louiNgn/mitten40/README.md

# mitten40 
## An ortholinear keyboard with a joystick!

The mitten40 is a 46-key, split-spacebar ortholinear keyboard with a customizable OLED screen and joystick.

### PCB Render



### PCB Layout



### Schematic


# key layout


# firmware
The mitten40 utilizes [QMK firmware](https://qmk.fm/) 

Expect coming changes to C scripts seen in the project, it's untested currently!

# case






The mitten40 utilizes a 3D printed gasket-mount case secured with M3 heat set inserts and screws.

# build guide (TO BE UPDATED ONCE I GET MY HANDS ON IT)
[View bills of materials here!](BOMs)

PCB SMD components: Options include hotplate/hot air soldering at home, assembly by a third-party service (JLCPCB is my choice), or, if you're cracked enough, hand soldering with a soldering iron.

###### FOR THE ASSEMBLY .CSV GO [HERE](production/BOM_PCBAssembly.csv)

|Designator |Footprint |Quantity|Value |LCSC Part #|
|---|---|---|---|---|
|C1, C2, C3, C5, C8 |402 |5 |100nF |C60474 |
|C10, C11, C7 |402 |3 |1uF |C29266 |
|C4, C9 |402 |2 |4.7uF |C368809 |
|C6 |402 |1 |10nF |C15195 |
|D1, D10, D11, D12, D13, D14, D15, D16, D17, D18, D19, D2, D20, D21, D22, D23, D24, D25, D26, D27, D28, D29, D3, D30, D31, D32, D33, D34, D35, D36, D37, D38, D39, D4, D40, D41, D42, D43, D44, D45, D46, D5, D6, D7, D8, D9|D_SOD-123 |46 |D |C2972760 |
|F1 |603 |1 |500mA |C136327 |
|J3 |USB_C_Receptacle_HCTL_HC-TYPE-C-16P-01A|1 |USB_C_Receptacle_USB2.0_16P|C2765186 |
|R1 |402 |1 |10k |C60490 |
|R2, R3 |402 |2 |5.1k |C25905 |
|SW0 |SW_SPST_TL3342 |1 |SW_Push |C2886898 |
|U1 |LQFP-48_7x7mm_P0.5mm |1 |STM32F072CBT6 |C81720 |
|U2 |SOT-23-6 |1 |USBLC6-2SC6 |C7519 |
|U3 |SOT-23-3 |1 |XC6206P332MR-MS |C5252899 |

Before continuing, flash QMK firmware on to the keyboard, and use a pair of conductive tweezers to test the PCB for any issues (firmware error, damaged PCB, unresponsive through-hole pins, etc...), and resolve any issues that arises (which may include reordering your PCB).

PCB through-hole components: With sufficient flux and a soldering iron, solder Cherry-MX compatible switches, joystick, and OLED screen through their respective through-hole components. Optionally, solder a 4-pin socket through the OLED screen footprint if you want easily-swappable screens/afraid of damaging the screen when soldering directly.
#### IMPORTANT: REMEMBER TO MOUNT SWITCHES ON TO THE PLATE BEFORE SANDWICHING THEM TO THE PCB AND SOLDERING THEM!!!!

|Designator |Part |Quantity|Additional notes |
|---|---|---|---|
|SW1-46 |MX-Compatible Switches |46 | |
|SW48 |PS2-style analog joystick |1 |Something similar to the [SparkFun joystick](https://www.sparkfun.com/thumb-joystick.html) should work|
|J2 |0.91" 4-pin OLED Display | |Solder sockets on if you want|

Case assembly:
+ Assuming you've mounted the switches on to the plate and the PCB before soldering, begin attaching foam gaskets you've bought on to the top of the small "fins" extruded around the plate on both sides, trimming excess material where necessary to ensure a tight fit.
+ Use your soldering iron, and optionally a heat-set insert press for more precision, push the M3 heat set inserts into their respective holes in the top housing of the keyboard case, before letting everything cool down. (NOTE: DO NOT PRESS TOO FAR AS IT MIGHT GO THROUGH THE ENTIRE HOUSING)
+ Sandwich the PCB-plate between the top and the bottom housing, ensuring the entire contraption is sitting flush in between them.
+ Use M3 screws you've bought to bolt everything together from the bottom housing, tightening it too hard may lead to the housings cracking so please avoid that.
+ Finally, attach the anti-slip nubs on to the bottom of the case in their respective nub holes, and wait for it to set into the PCB before using.

| Part | Quantity | Additional notes | Estimated total costs (may be pricier outside of my country | Links I used |
|---|---|---|---|---|
| Heat-set inserts (M3 * 4 * 4.5) | 8 | | $0.60 | [Shopee](https://shopee.vn/30-%E1%BB%90c-c%E1%BA%A5y-nhi%E1%BB%87t-%C4%91%E1%BB%93ng-M1.4-M2-M2.5-M3-M4-M5-M6-T%C3%A1n-Ren-C%E1%BA%A5y-G%E1%BA%AFn-Nh%E1%BB%B1a-Voron-c%E1%BA%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) |
| Threaded Socket Head Cap M3 Screws | 8 | A shank around 16mm should work, though it *might* go up to 18mm. Proceed with caution. | $0.80 | [Shopee](https://shopee.vn/20C%C3%A1i-Bulong-%E1%BB%91c-Tr%E1%BB%A5-L%E1%BB%A5c-Gi%C3%A1c-trong-M3-M4-M5-M6-M8-inox304-i.801113520.42860368235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) |
| 70mm * 3.5mm * 2mm Poron Foam Gaskets  | 12 | 2mms of thickness, cut down if need be. | $6.39 | [Shopee](https://shopee.vn/B%E1%BB%99-5-Mi%E1%BA%BFng-Foam-Gasket-Poron-Thay-Th%E1%BA%BF-Cho-B%C3%A0n-Ph%C3%ADm-C%C6%A1-Gasket-Mount-Yeti-Mech-i.1065372747.46601199338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) |
| 3M SJ5302 Anti-stick nubs | 4 | | $1.20 | [Shopee](https://shopee.vn/30-N%C3%BAt-%C4%90%E1%BB%87m-Ch%E1%BB%91ng-v%E1%BB%A1-%C4%90i%E1%BB%87n-Tho%E1%BA%A1i-3M-SJ5302-(N%C3%BAt-V%C3%B2m-C%E1%BA%A7u)-v%C3%A0-20-N%C3%BAt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) |
| Filament (PLA) | ~270+ grams or ~90m (PLA) | May vary with different filaments and print settings | ~$5.40 | |
