louiNgn/mitten40/image-1.png

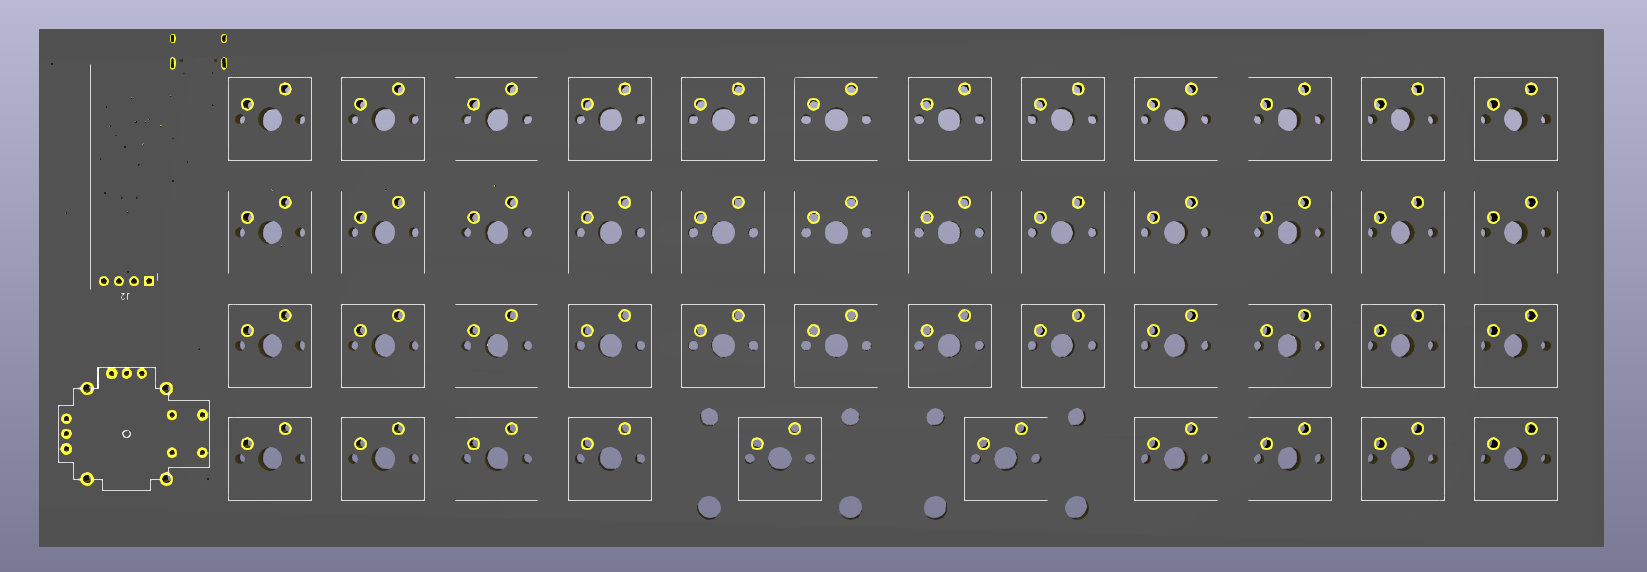
image-1.png
