louiNgn/mitten40/image-3.png

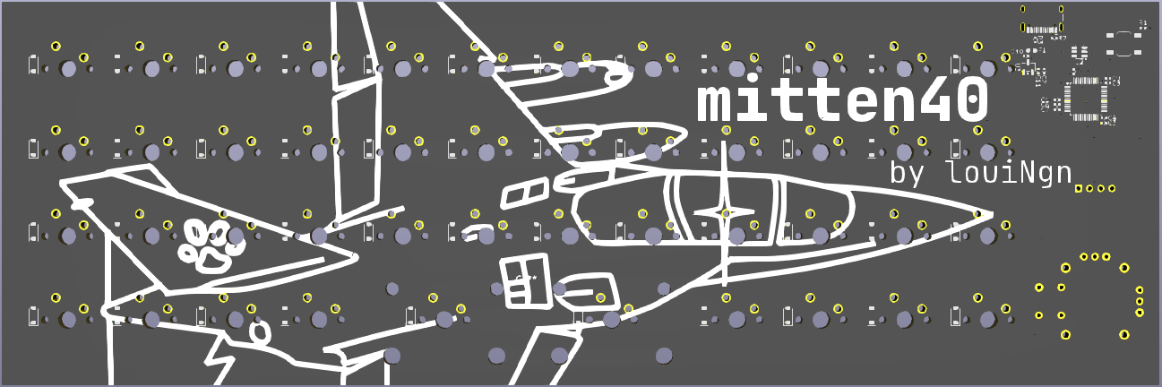
image-3.png
