louiNgn/mitten40/image.png

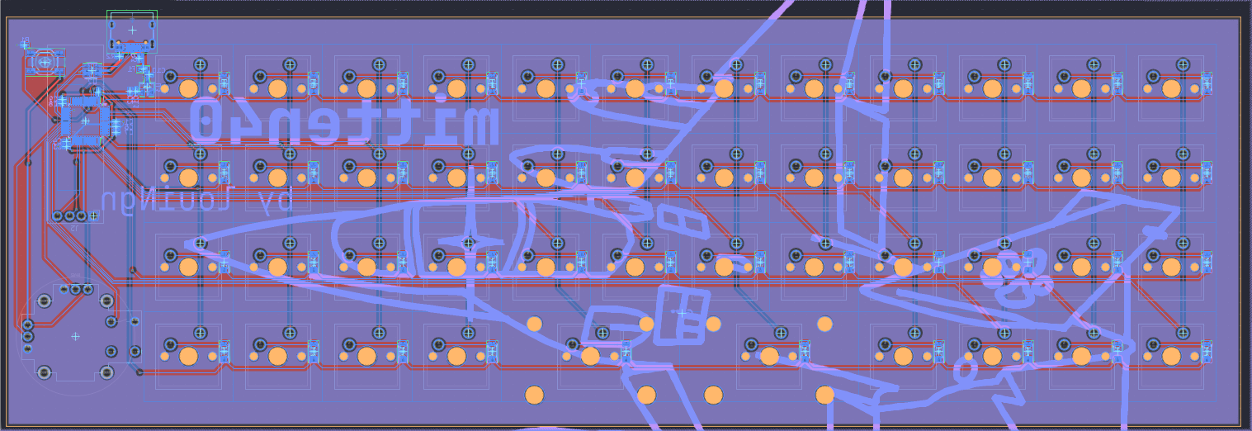
image.png
