louiNgn/mitten40/mitten40percentPCB/production/BOM_bom.csv

Designator | Footprint | Quantity | Value | LCSC Part #
C1, C2, C3, C5, C8 | 0402 | 5 | 100nF
C10, C11, C7 | 0402 | 3 | 1uF
C4, C9 | 0402 | 2 | 4.7uF
C6 | 0402 | 1 | 10nF
D1, D10, D11, D12, D13, D14, D15, D16, D17, D18, D19, D2, D20, D21, D22, D23, D24, D25, D26, D27, D28, D29, D3, D30, D31, D32, D33, D34, D35, D36, D37, D38, D39, D4, D40, D41, D42, D43, D44, D45, D46, D5, D6, D7, D8, D9 | D_SOD-123 | 46 | D
F1 | 0603 | 1 | 500mA
J2 | ER_OLEDM0.91_1x-I2C | 1 | I2C
J3 | USB_C_Receptacle_HCTL_HC-TYPE-C-16P-01A | 1 | USB_C_Receptacle_USB2.0_16P
R1 | 0402 | 1 | 10k
R2, R3 | 0402 | 2 | 5.1k
SW0 | SW_SPST_TL3342 | 1 | SW_Push
SW1, SW10, SW11, SW12, SW13, SW14, SW15, SW16, SW17, SW18, SW19, SW2, SW20, SW21, SW22, SW23, SW24, SW25, SW26, SW27, SW28, SW29, SW3, SW30, SW31, SW32, SW33, SW34, SW35, SW36, SW37, SW38, SW39, SW4, SW40, SW43, SW44, SW45, SW46, SW5, SW6, SW7, SW8, SW9 | SW_Cherry_MX_1.00u_PCB | 44 | SW_Push_45deg
SW41, SW42 | SW_Cherry_MX_2.00u_PCB | 2 | SW_Push_45deg
SW48 | Joystick_PTH | 1 | Joystick
U1 | LQFP-48_7x7mm_P0.5mm | 1 | STM32F072CBT6
U2 | SOT-23-6 | 1 | USBLC6-2SC6
U3 | SOT-23-3 | 1 | XC6206PxxxMR
