louiNgn/mitten40/mitten40percent.csv

Id | Designator | Footprint | Quantity | Designation | Supplier and ref
1 | C1, C2, C3, C5, C8 | C_0402_1005Metric | 5 | 100nF
2 | C4, C9 | C_0402_1005Metric | 2 | 4.7uF
3 | C6 | C_0402_1005Metric | 1 | 10nF
4 | C7, C10, C11 | C_0402_1005Metric | 3 | 1uF
5 | D1, D2, D3, D4, D5, D6, D7, D8, D9, D10, D11, D12, D13, D14, D15, D16, D17, D18, D19, D20, D21, D22, D23, D24, D25, D26, D27, D28, D29, D30, D31, D32, D33, D34, D35, D36, D37, D38, D39, D40, D41, D42, D43, D44, D45, D46 | D_SOD-123 | 46 | D
6 | F1 | Fuse_0603_1608Metric | 1 | 500mA
7 | J2 | ER_OLEDM0.91_1x-I2C | 1 | I2C
8 | J3 | USB_C_Receptacle_HCTL_HC-TYPE-C-16P-01A | 1 | USB_C_Receptacle_USB2.0_16P
9 | R1 | R_0402_1005Metric | 1 | 10k
10 | R2, R3 | R_0402_1005Metric | 2 | 5.1k
11 | SW0 | SW_SPST_TL3342 | 1 | SW_Push
12 | SW1, SW2, SW3, SW4, SW5, SW6, SW7, SW8, SW9, SW10, SW11, SW12, SW13, SW14, SW15, SW16, SW17, SW18, SW19, SW20, SW21, SW22, SW23, SW24, SW25, SW26, SW27, SW28, SW29, SW30, SW31, SW32, SW33, SW34, SW35, SW36, SW37, SW38, SW39, SW40, SW43, SW44, SW45, SW46 | SW_Cherry_MX_1.00u_PCB | 44 | SW_Push_45deg
13 | SW41, SW42 | SW_Cherry_MX_2.00u_PCB | 2 | SW_Push_45deg
14 | SW48 | Joystick_PTH | 1 | Joystick
15 | U1 | LQFP-48_7x7mm_P0.5mm | 1 | STM32F072CBT6
16 | U2 | SOT-23-6 | 1 | USBLC6-2SC6
17 | U3 | SOT-23-3 | 1 | XC6206PxxxMR
