louiNgn/mitten40/mitten40Case/caseBottom.3mf

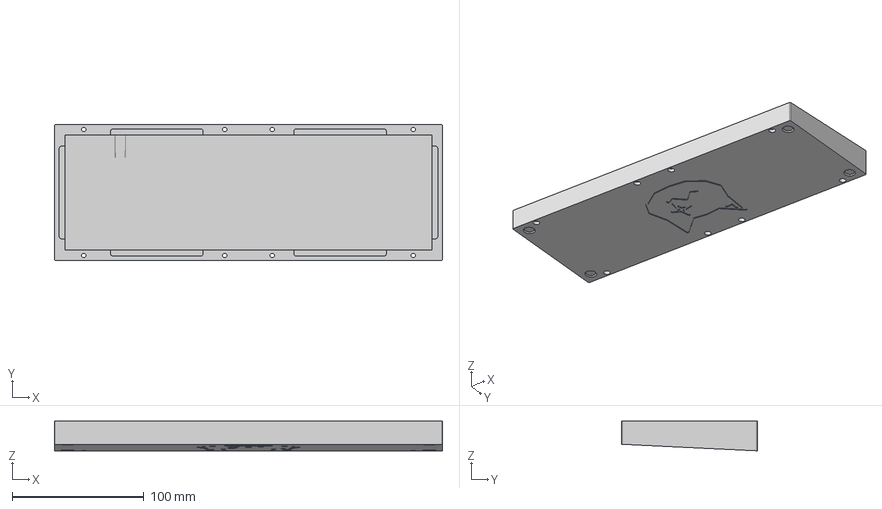
[picture p4: CAD file, 2026-10-22]
mitten40Case/caseBottom.3mf
294.5 x 103.5 x 22.6 mm
