louiNgn/mitten40/mitten40percentPCB/mitten40PCB.step

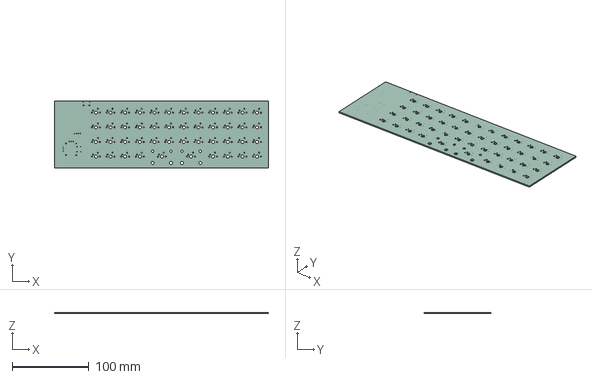
[picture p5: CAD file, 2026-10-19]
mitten40percentPCB/mitten40PCB.step
278.2 x 87.2 x 1.51 mm
