louiNgn/mitten40/mitten40Case/caseTop.3mf

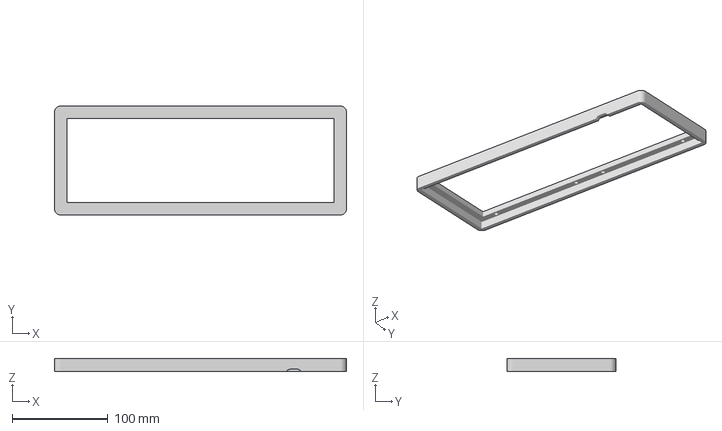
[picture p6: CAD file, 2026-10-18]
mitten40Case/caseTop.3mf
304.5 x 113.5 x 14.0 mm
