louiNgn/mitten40/mitten40Case/pcbPlate.3mf

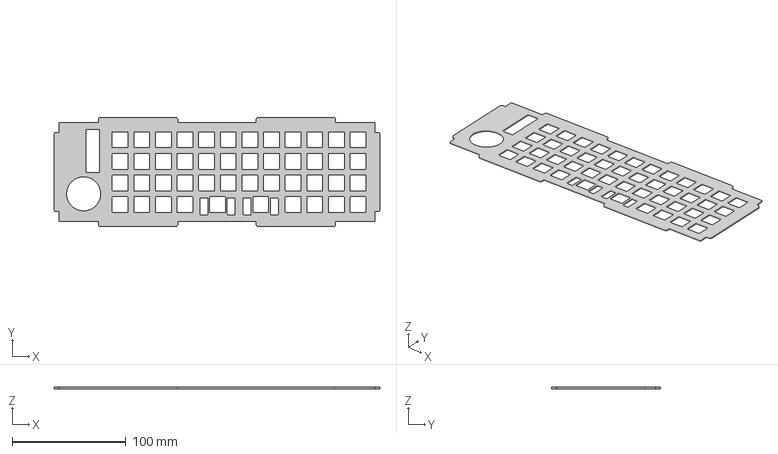
[picture p7: CAD file, 2026-10-18]
mitten40Case/pcbPlate.3mf
287.2 x 96.2 x 1.50 mm
