louiNgn/mitten40/(list of files, cad)

Other CAD files:
mitten40Case/caseBottom.f3d
mitten40Case/caseTop.f3d
mitten40Case/pcbPlate.f3d
