louiNgn/mitten40/mitten40percentPCB/mitten40percent.kicad_pcb

## KiCad design mitten40percentPCB/mitten40percent.kicad_pcb (2026-10-16)

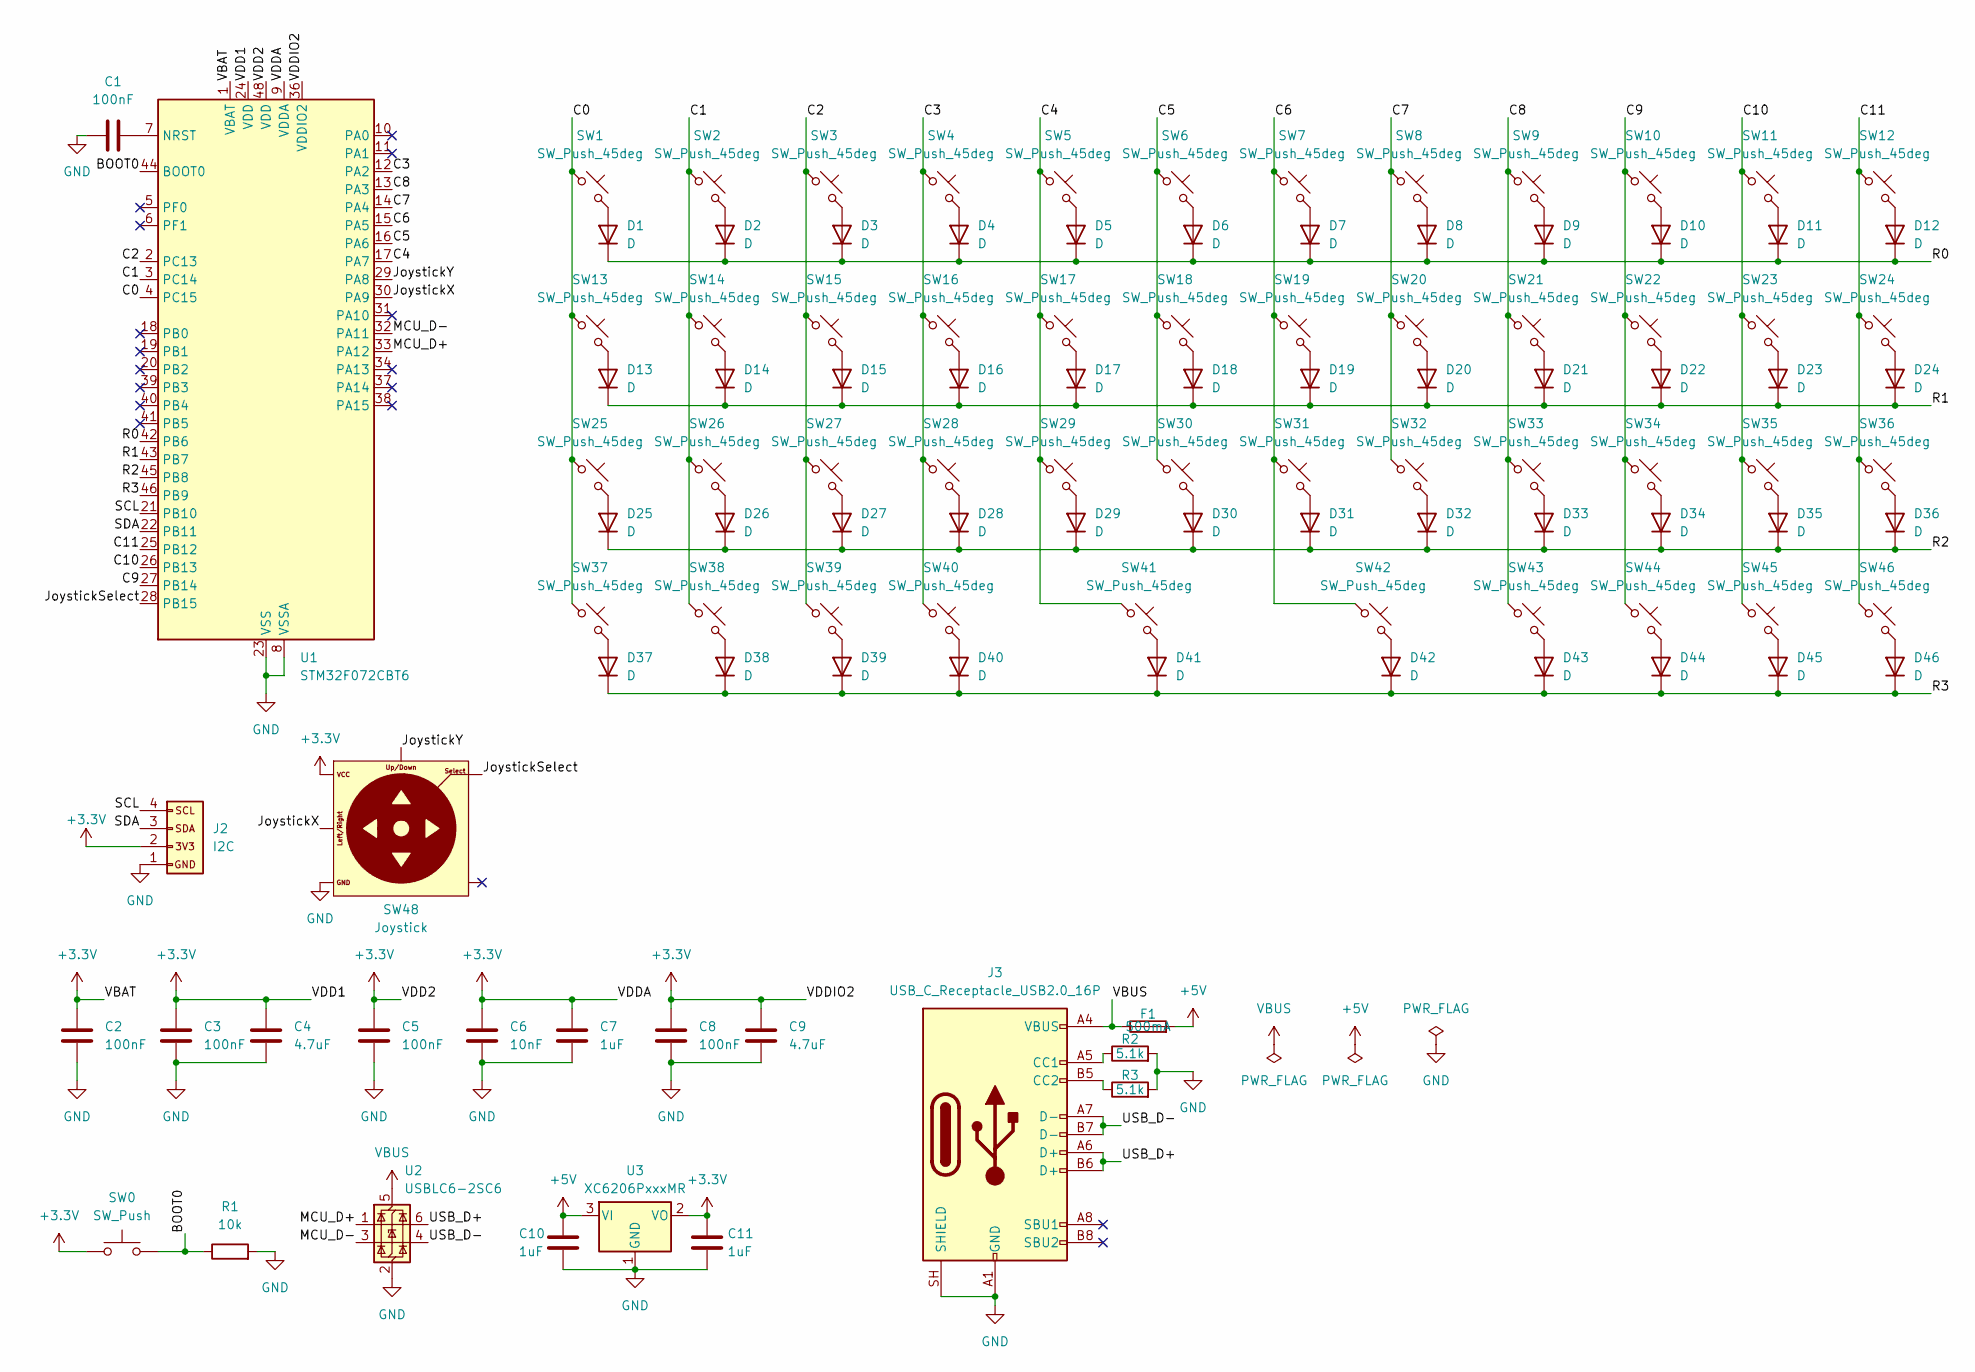
[picture p8: schematic mitten40percent.kicad_sch, mitten40 PCB]

Parts:
C1, C2, C3, C5, C8: 100nF; C_0402_1005Metric
C4, C9: 4.7uF; C_0402_1005Metric
C6: 10nF; C_0402_1005Metric
C7, C10, C11: 1uF; C_0402_1005Metric
D1, D2, D3, D4, D5, D6, D7, D8, D9, D10, D11, D12, D13, D14, D15, D16, D17, D18, D19, D20, D21, D22, D23, D24, D25, D26, D27, D28, D29, D30, D31, D32, D33, D34, D35, D36, D37, D38, D39, D40, D41, D42, D43, D44, D45, D46: D; D_SOD-123
F1: 500mA; Fuse_0603_1608Metric
J2: I2C; ER_OLEDM0.91_1x-I2C
J3: USB_C_Receptacle_USB2.0_16P; USB_C_Receptacle_HCTL_HC-TYPE-C-16P-01A
R1: 10k; R_0402_1005Metric
R2, R3: 5.1k; R_0402_1005Metric
SW0: SW_Push; SW_SPST_TL3342
SW1, SW2, SW3, SW4, SW5, SW6, SW7, SW8, SW9, SW10, SW11, SW12, SW13, SW14, SW15, SW16, SW17, SW18, SW19, SW20, SW21, SW22, SW23, SW24, SW25, SW26, SW27, SW28, SW29, SW30, SW31, SW32, SW33, SW34, SW35, SW36, SW37, SW38, SW39, SW40, SW43, SW44, SW45, SW46: SW_Push_45deg; SW_Cherry_MX_1.00u_PCB
SW41, SW42: SW_Push_45deg; SW_Cherry_MX_2.00u_PCB
SW48: Joystick; Joystick_PTH
U1: STM32F072CBT6; LQFP-48_7x7mm_P0.5mm
U2: USBLC6-2SC6; SOT-23-6
U3: XC6206PxxxMR; SOT-23-3

Connections:
+3.3V: C2.1, C3.1, C4.1, C5.1, C6.1, C7.1, C8.1, C9.1, C11.1, J2.2, SW0.1, SW48.VCC, U1.1 (VBAT), U1.9 (VDDA), U1.24 (VDD), U1.36 (VDDIO2), U1.48 (VDD), U3.2 (VO)
+5V: C10.1, F1.2, U3.3 (VI)
/BOOT0: R1.1, SW0.2, U1.44 (BOOT0)
/C0: SW1.1, SW13.1, SW25.1, SW37.1, U1.4 (PC15)
/C1: SW2.1, SW14.1, SW26.1, SW38.1, U1.3 (PC14)
/C2: SW3.1, SW15.1, SW27.1, SW39.1, U1.2 (PC13)
/C3: SW4.1, SW16.1, SW28.1, SW40.1, U1.12 (PA2)
/C4: SW5.1, SW17.1, SW29.1, SW41.1, U1.17 (PA7)
/C5: SW6.1, SW18.1, SW30.1, U1.16 (PA6)
/C6: SW7.1, SW19.1, SW31.1, SW42.1, U1.15 (PA5)
/C7: SW8.1, SW20.1, SW32.1, U1.14 (PA4)
/C8: SW9.1, SW21.1, SW33.1, SW43.1, U1.13 (PA3)
/C9: SW10.1, SW22.1, SW34.1, SW44.1, U1.27 (PB14)
/C10: SW11.1, SW23.1, SW35.1, SW45.1, U1.26 (PB13)
/C11: SW12.1, SW24.1, SW36.1, SW46.1, U1.25 (PB12)
/JoystickSelect: SW48.Select, U1.28 (PB15)
/JoystickX: SW48.Horizontal, U1.30 (PA9)
/JoystickY: SW48.Vertical, U1.29 (PA8)
/MCU_D+: U1.33 (PA12), U2.1 (I/O1)
/MCU_D-: U1.32 (PA11), U2.3 (I/O2)
/R0: D1.1 (K), D2.1 (K), D3.1 (K), D4.1 (K), D5.1 (K), D6.1 (K), D7.1 (K), D8.1 (K), D9.1 (K), D10.1 (K), D11.1 (K), D12.1 (K), U1.42 (PB6)
/R1: D13.1 (K), D14.1 (K), D15.1 (K), D16.1 (K), D17.1 (K), D18.1 (K), D19.1 (K), D20.1 (K), D21.1 (K), D22.1 (K), D23.1 (K), D24.1 (K), U1.43 (PB7)
/R2: D25.1 (K), D26.1 (K), D27.1 (K), D28.1 (K), D29.1 (K), D30.1 (K), D31.1 (K), D32.1 (K), D33.1 (K), D34.1 (K), D35.1 (K), D36.1 (K), U1.45 (PB8)
/R3: D37.1 (K), D38.1 (K), D39.1 (K), D40.1 (K), D41.1 (K), D42.1 (K), D43.1 (K), D44.1 (K), D45.1 (K), D46.1 (K), U1.46 (PB9)
/SCL: J2.4, U1.21 (PB10)
/SDA: J2.3, U1.22 (PB11)
/USB_D+: J3.A6 (D+), J3.B6 (D+), U2.6 (I/O1)
/USB_D-: J3.A7 (D-), J3.B7 (D-), U2.4 (I/O2)
GND: C1.1, C2.2, C3.2, C4.2, C5.2, C6.2, C7.2, C8.2, C9.2, C10.2, C11.2, J2.1, J3.A1 (GND), J3.A12 (GND), J3.B1 (GND), J3.B12 (GND), J3.SH (SHIELD), R1.2, R2.2, R3.2, SW48.GND, U1.8 (VSSA), U1.23 (VSS), U1.35 (VSS), U1.47 (VSS), U2.2 (GND), U3.1 (GND)
unnamed: D1.2 (A), SW1.2
unnamed: D2.2 (A), SW2.2
unnamed: D3.2 (A), SW3.2
unnamed: D4.2 (A), SW4.2
unnamed: D5.2 (A), SW5.2
unnamed: D6.2 (A), SW6.2
unnamed: D7.2 (A), SW7.2
unnamed: D8.2 (A), SW8.2
unnamed: D9.2 (A), SW9.2
unnamed: D10.2 (A), SW10.2
unnamed: D11.2 (A), SW11.2
unnamed: D12.2 (A), SW12.2
unnamed: D13.2 (A), SW13.2
unnamed: D14.2 (A), SW14.2
unnamed: D15.2 (A), SW15.2
unnamed: D16.2 (A), SW16.2
unnamed: D17.2 (A), SW17.2
unnamed: D18.2 (A), SW18.2
unnamed: D19.2 (A), SW19.2
unnamed: D20.2 (A), SW20.2
unnamed: D21.2 (A), SW21.2
unnamed: D22.2 (A), SW22.2
unnamed: D23.2 (A), SW23.2
unnamed: D24.2 (A), SW24.2
unnamed: D25.2 (A), SW25.2
unnamed: D26.2 (A), SW26.2
unnamed: D27.2 (A), SW27.2
unnamed: D28.2 (A), SW28.2
unnamed: D29.2 (A), SW29.2
unnamed: D30.2 (A), SW30.2
unnamed: D31.2 (A), SW31.2
unnamed: D32.2 (A), SW32.2
unnamed: D33.2 (A), SW33.2
unnamed: D34.2 (A), SW34.2
unnamed: D35.2 (A), SW35.2
unnamed: D36.2 (A), SW36.2
unnamed: D37.2 (A), SW37.2
unnamed: D38.2 (A), SW38.2
unnamed: D39.2 (A), SW39.2
unnamed: D40.2 (A), SW40.2
unnamed: D41.2 (A), SW41.2
unnamed: D42.2 (A), SW42.2
unnamed: D43.2 (A), SW43.2
unnamed: D44.2 (A), SW44.2
unnamed: D45.2 (A), SW45.2
unnamed: D46.2 (A), SW46.2
unnamed: J3.A5 (CC1), R2.1
unnamed: J3.B5 (CC2), R3.1
unnamed: C1.2, U1.7 (NRST)
VBUS: F1.1, J3.A4 (VBUS), J3.A9 (VBUS), J3.B4 (VBUS), J3.B9 (VBUS), U2.5 (VBUS)

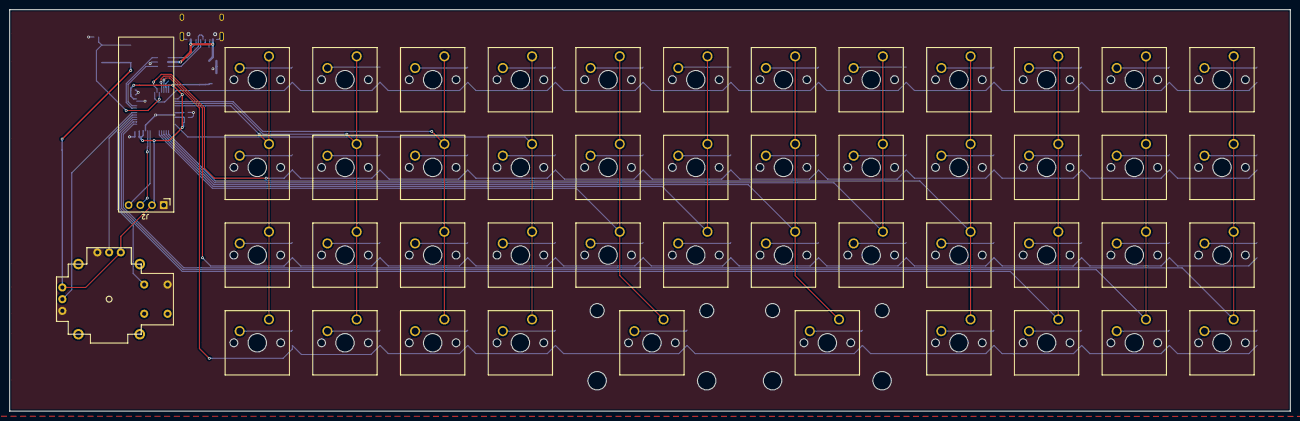
[picture p9: board mitten40percent.kicad_pcb from above]

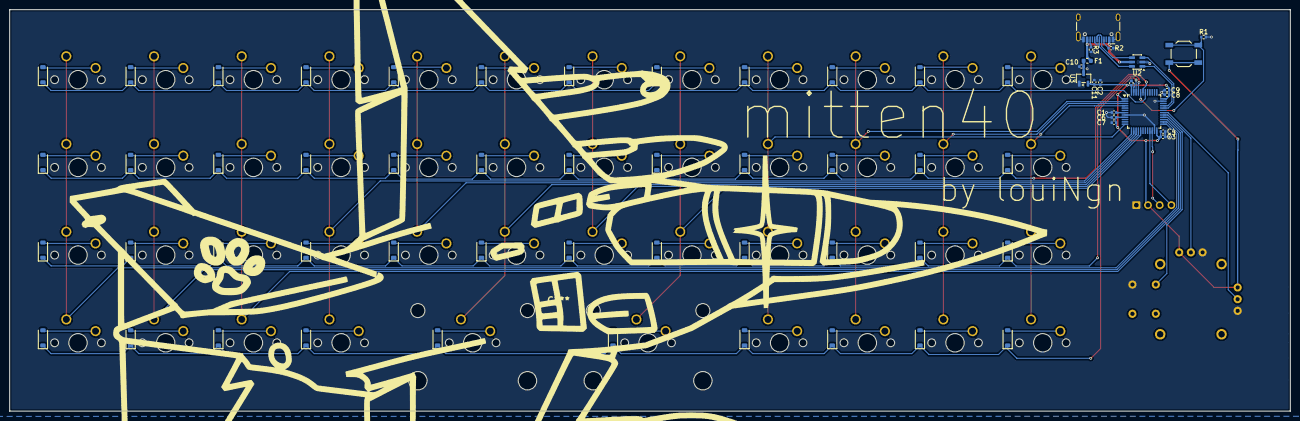
[picture p10: board mitten40percent.kicad_pcb from below]

Board: 2 copper layers, 278.2 x 87.2 mm, 114 parts (66 on the bottom side), 79 nets.
