louiNgn/mitten40/(commit log)

2026-09-28 added stm32 and a few capacitors, i have no idea wtf im doing
    [mitten40percent.kicad_pcb, mitten40percent.kicad_sch]
2026-10-03 stm32 wiring finally finished!!!! (theres a non-zero percent chance it will burn my house down)
    [mitten40percent.kicad_sch]
2026-10-05 added rows and columns
    [mitten40percent.kicad_sch]
2026-10-06 completed first passthrough of schematic, implemented a joystick and a screen
    [mitten40percent.kicad_sch]
2026-10-07 implemented key layout on pcb, partially done with implementation of stm32
    [mitten40percent.kicad_pcb, mitten40percent.kicad_sch]
2026-10-07 removed two unecessary .md files
    [mitten40percent.kicad_sch]
2026-10-08 finished wiring individual components (stm32, usb-c port, reset button), routed the matrix to the mcu
    [mitten40percent.kicad_pcb, mitten40percent.kicad_sch]
2026-10-09 finished routing and ground fill, now on to santiy checks
    [mitten40percent.kicad_pcb, mitten40percent.kicad_sch]
2026-10-10 finalized routing
    [mitten40percent.kicad_pcb, mitten40percent.kicad_sch]
2026-10-11 added silkscreen art
2026-10-11 added gerber and drill files
2026-10-12 fixed up a potential clearance issue between joystick and keycaps, fingers crossed
2026-10-12 fixed gerber files
2026-10-16 added bom and position files
2026-10-16 added plate cad files
2026-10-18 added case files (.3mf and .f3d)
2026-10-19 updated pcb .step file
2026-10-19 renamed BOM.csv file for better distiguishing later
2026-10-26 Add PLA filament requirement to README
    Added filament requirement for PLA to the materials list.
2026-10-26 Include filament requirement for PLA
    Added filament requirement for PLA with estimated weight and length.
2026-10-27 added some links and costs for case bom
